ianeyk/magic-dds/report/images/dac_grid_schematic.png

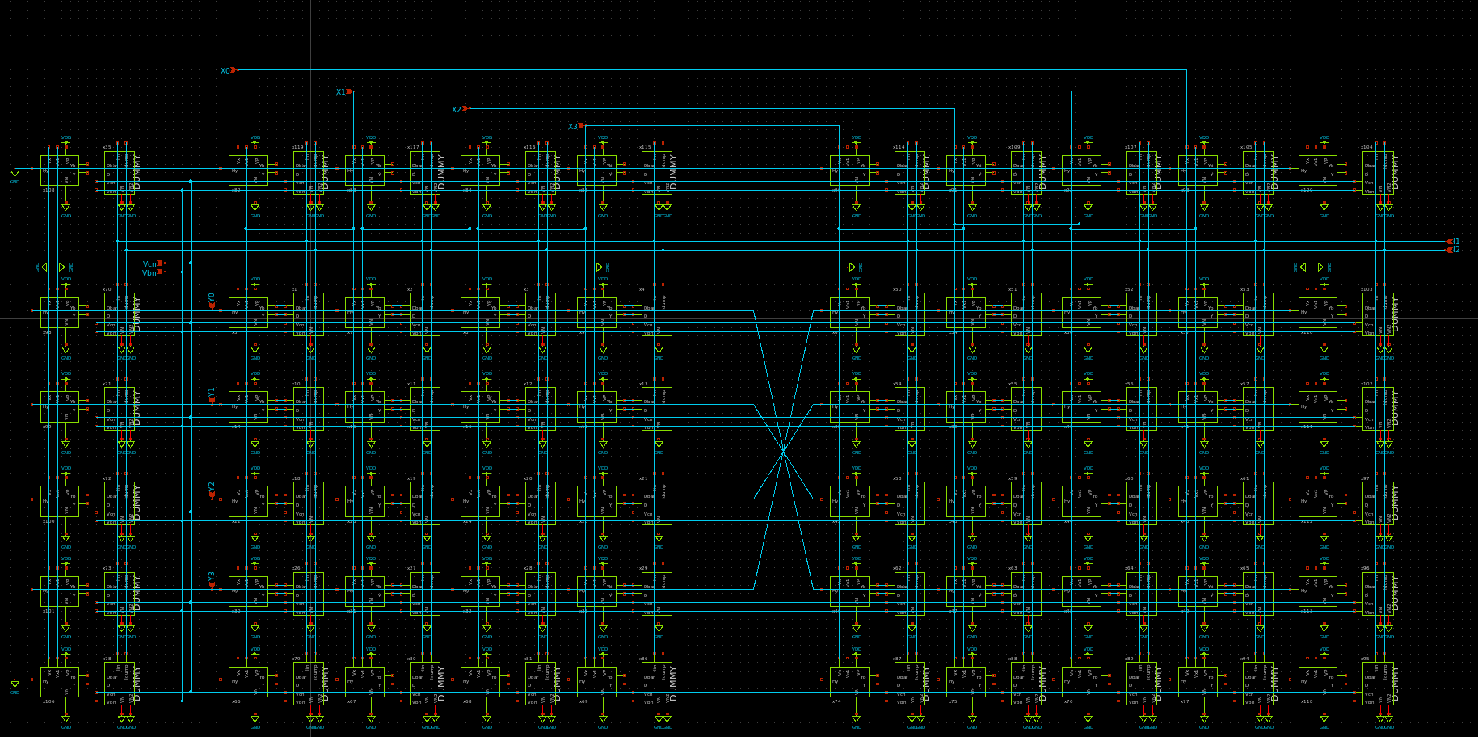
report/images/dac_grid_schematic.png
