ianeyk/magic-dds/report/images/not used yet/full_system_schematic_for_final_lvs.png

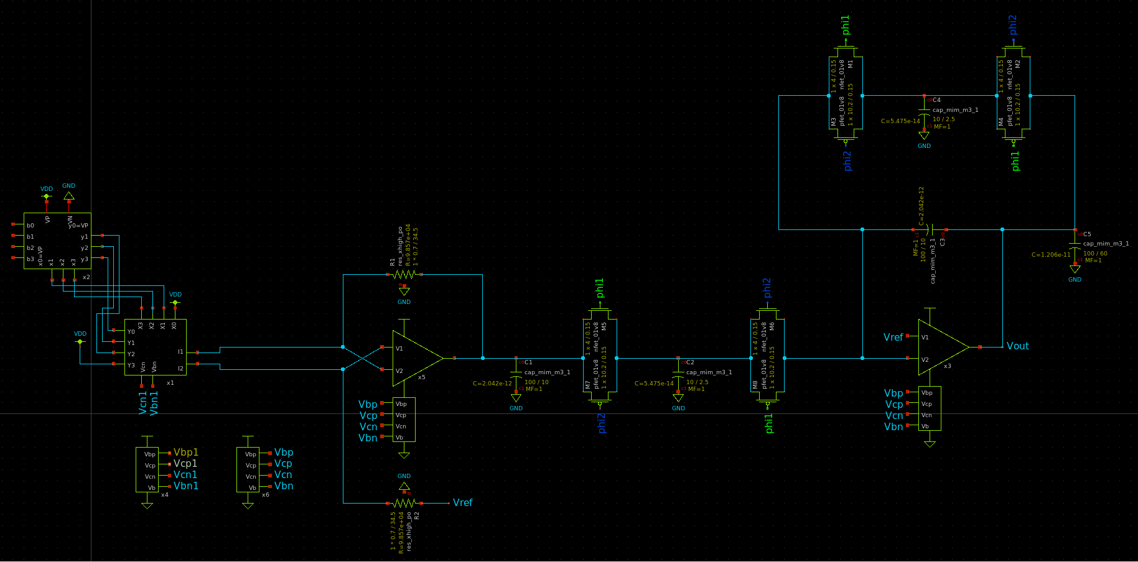
report/images/not used yet/full_system_schematic_for_final_lvs.png
