ianeyk/magic-dds/report/images/not used yet/output_sin_wave_from_switched_capacitor_16ns_clock_period.png

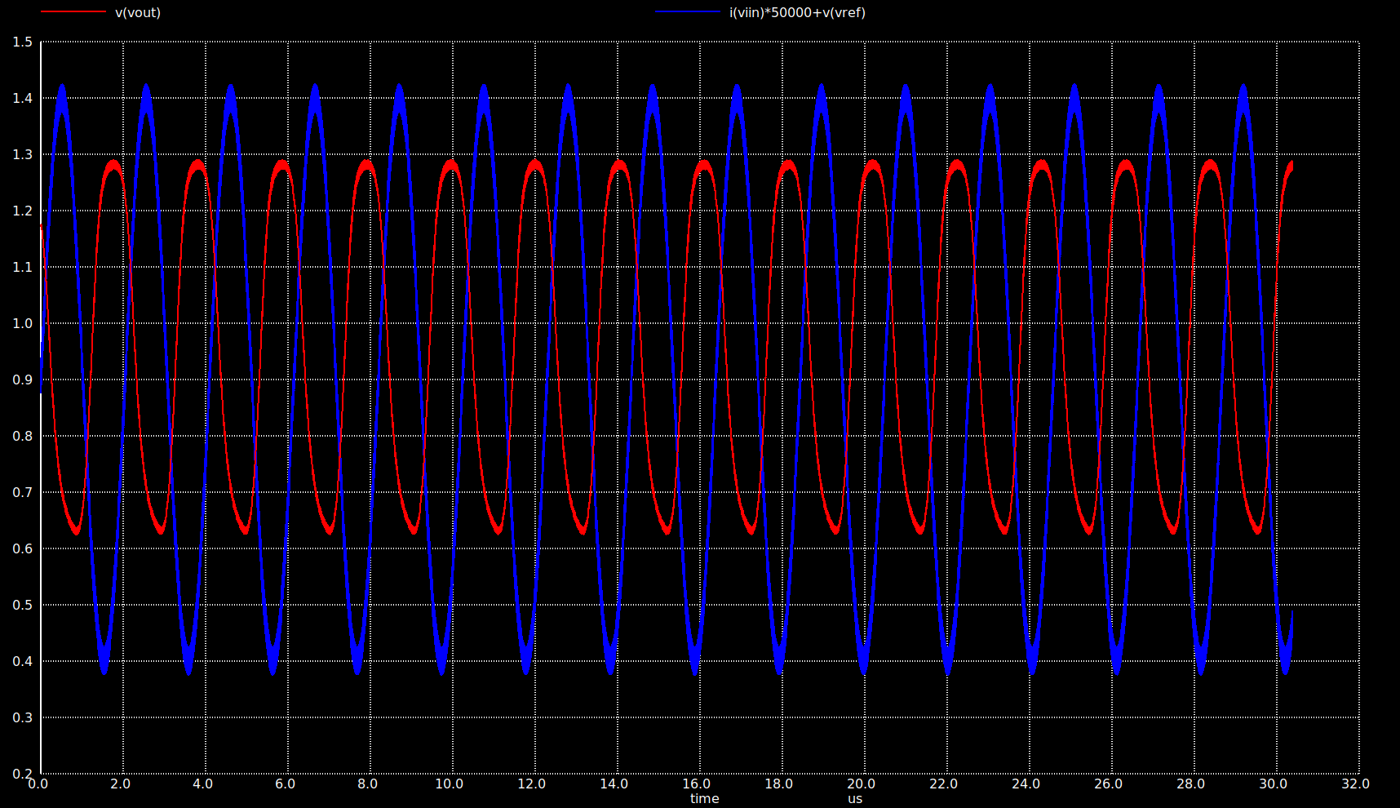
report/images/not used yet/output_sin_wave_from_switched_capacitor_16ns_clock_period.png
