ianeyk/magic-dds/report/images/not used yet/Screenshot from 2023-12-17 03-46-52.png

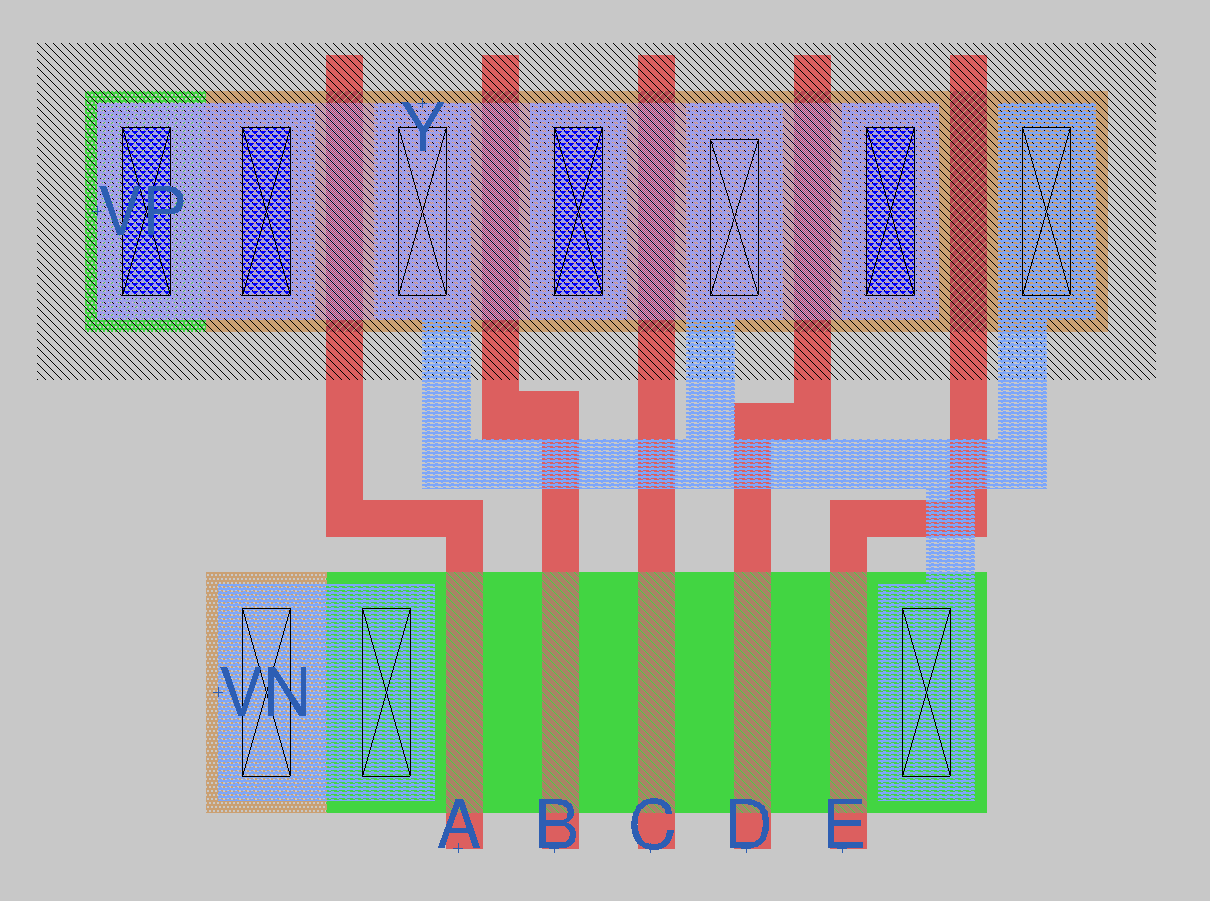
report/images/not used yet/Screenshot from 2023-12-17 03-46-52.png
