ianeyk/magic-dds/report/images/switched_capacitor_circuit_2.png

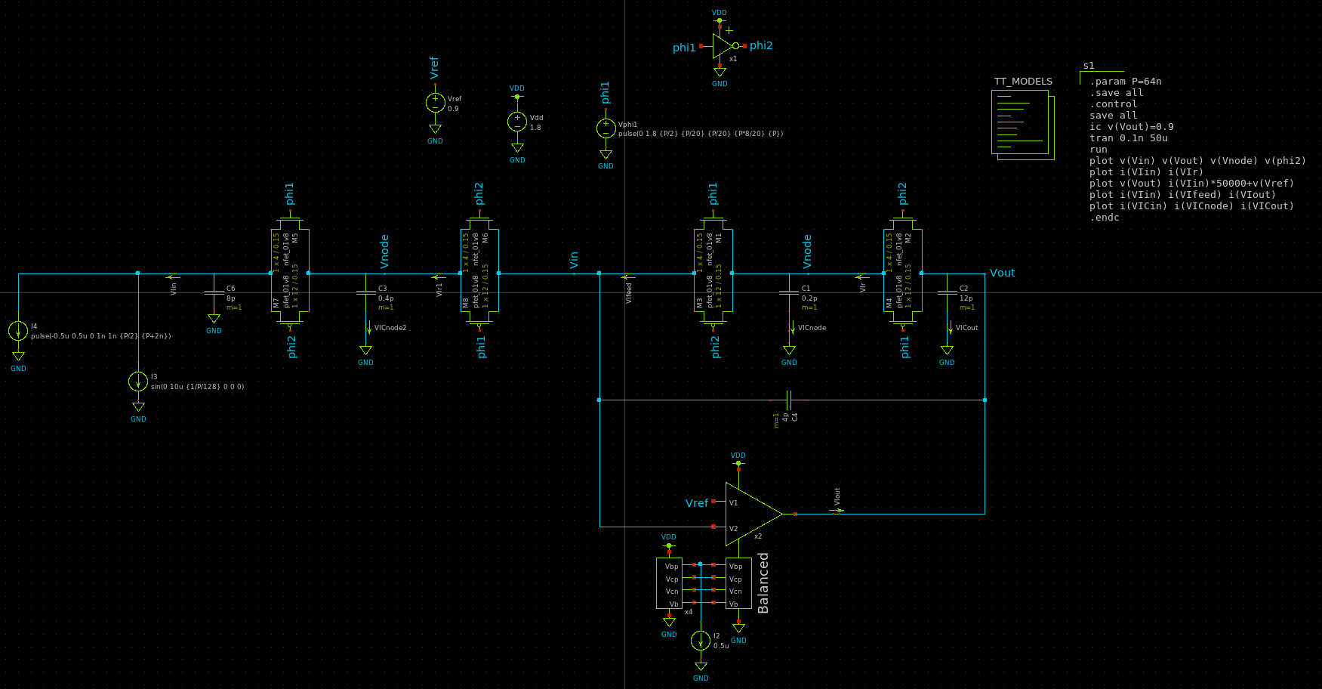
report/images/switched_capacitor_circuit_2.png
