ianeyk/magic-dds/report/images/unit_cell_current_steering_schematic.png

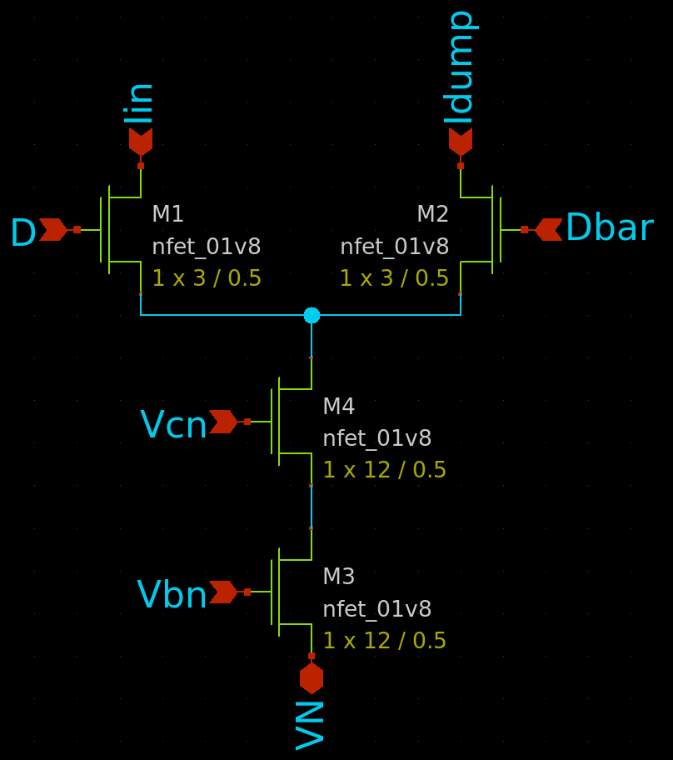
report/images/unit_cell_current_steering_schematic.png
