ianeyk/magic-dds/report/images/unit_cell_decoder_schematic.png

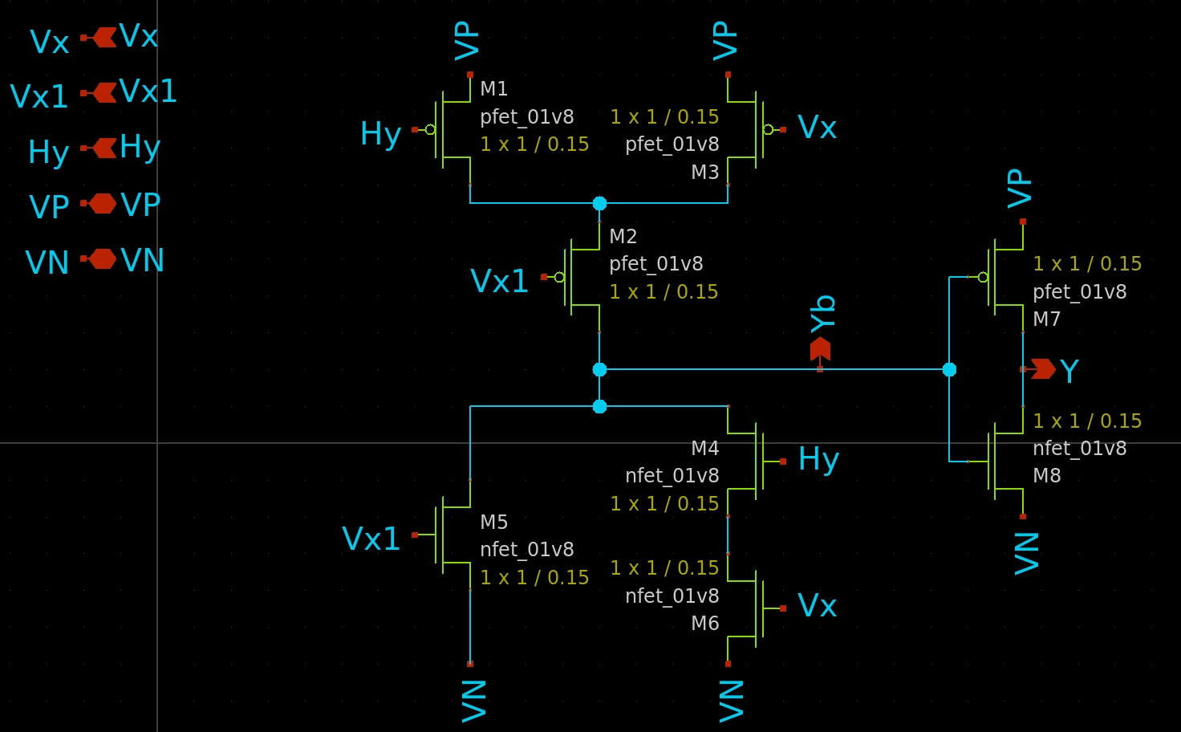
report/images/unit_cell_decoder_schematic.png
