ianeyk/magic-dds/magic/dac_with_output_stage_lvs.spice

** sch_path: /home/madvlsi/dev/git/magic-dds/lvs/dac_with_output_stage_lvs.sch
**.subckt dac_with_output_stage_lvs
x1 Vcn1 Vbn1 net4 net3 net1 net2 net6 net7 net8 VDD VDD net5 current_steering_dac
x2 net5 net8 VDD net13 net14 net4 net7 net15 net16 GND net6 net3 binary_decoder_4bit_lvs
x5 Vbp Vcp net9 net2 net1 Vcn Vbn opamp_balanced_lvs
x4 Vbp1 Vcn1 Vcp1 Vbn1 bias_schematic_lvs
x6 Vbp Vcn Vcp Vbn bias_schematic_lvs
x3 Vbp Vcp Vout Vref net11 Vcn Vbn opamp_balanced_lvs
XR1 net9 net1 GND sky130_fd_pr__res_xhigh_po W=0.7 L=34.5 mult=1 m=1
XR2 net2 Vref GND sky130_fd_pr__res_xhigh_po W=0.7 L=34.5 mult=1 m=1
XC1 net9 GND sky130_fd_pr__cap_mim_m3_1 W=100 L=10 MF=1 m=1
XM5 net10 phi1 net9 GND sky130_fd_pr__nfet_01v8 L=0.15 W=4 nf=1 ad='int((nf+1)/2) * W/nf * 0.29' as='int((nf+2)/2) * W/nf * 0.29'
+ pd='2*int((nf+1)/2) * (W/nf + 0.29)' ps='2*int((nf+2)/2) * (W/nf + 0.29)' nrd='0.29 / W' nrs='0.29 / W'
+ sa=0 sb=0 sd=0 mult=1 m=1
XM6 net11 phi2 net10 GND sky130_fd_pr__nfet_01v8 L=0.15 W=4 nf=1 ad='int((nf+1)/2) * W/nf * 0.29' as='int((nf+2)/2) * W/nf * 0.29'
+ pd='2*int((nf+1)/2) * (W/nf + 0.29)' ps='2*int((nf+2)/2) * (W/nf + 0.29)' nrd='0.29 / W' nrs='0.29 / W'
+ sa=0 sb=0 sd=0 mult=1 m=1
XM7 net10 phi2 net9 VDD sky130_fd_pr__pfet_01v8 L=0.15 W=10.2 nf=1 ad='int((nf+1)/2) * W/nf * 0.29' as='int((nf+2)/2) * W/nf * 0.29'
+ pd='2*int((nf+1)/2) * (W/nf + 0.29)' ps='2*int((nf+2)/2) * (W/nf + 0.29)' nrd='0.29 / W' nrs='0.29 / W'
+ sa=0 sb=0 sd=0 mult=1 m=1
XM8 net11 phi1 net10 VDD sky130_fd_pr__pfet_01v8 L=0.15 W=10.2 nf=1 ad='int((nf+1)/2) * W/nf * 0.29'
+ as='int((nf+2)/2) * W/nf * 0.29' pd='2*int((nf+1)/2) * (W/nf + 0.29)' ps='2*int((nf+2)/2) * (W/nf + 0.29)'
+ nrd='0.29 / W' nrs='0.29 / W' sa=0 sb=0 sd=0 mult=1 m=1
XC2 net10 GND sky130_fd_pr__cap_mim_m3_1 W=10 L=2.5 MF=1 m=1
XC3 Vout net11 sky130_fd_pr__cap_mim_m3_1 W=100 L=10 MF=1 m=1
XM1 net12 phi1 net11 GND sky130_fd_pr__nfet_01v8 L=0.15 W=4 nf=1 ad='int((nf+1)/2) * W/nf * 0.29' as='int((nf+2)/2) * W/nf * 0.29'
+ pd='2*int((nf+1)/2) * (W/nf + 0.29)' ps='2*int((nf+2)/2) * (W/nf + 0.29)' nrd='0.29 / W' nrs='0.29 / W'
+ sa=0 sb=0 sd=0 mult=1 m=1
XM2 Vout phi2 net12 GND sky130_fd_pr__nfet_01v8 L=0.15 W=4 nf=1 ad='int((nf+1)/2) * W/nf * 0.29' as='int((nf+2)/2) * W/nf * 0.29'
+ pd='2*int((nf+1)/2) * (W/nf + 0.29)' ps='2*int((nf+2)/2) * (W/nf + 0.29)' nrd='0.29 / W' nrs='0.29 / W'
+ sa=0 sb=0 sd=0 mult=1 m=1
XM3 net12 phi2 net11 VDD sky130_fd_pr__pfet_01v8 L=0.15 W=10.2 nf=1 ad='int((nf+1)/2) * W/nf * 0.29'
+ as='int((nf+2)/2) * W/nf * 0.29' pd='2*int((nf+1)/2) * (W/nf + 0.29)' ps='2*int((nf+2)/2) * (W/nf + 0.29)'
+ nrd='0.29 / W' nrs='0.29 / W' sa=0 sb=0 sd=0 mult=1 m=1
XM4 Vout phi1 net12 VDD sky130_fd_pr__pfet_01v8 L=0.15 W=10.2 nf=1 ad='int((nf+1)/2) * W/nf * 0.29' as='int((nf+2)/2) * W/nf * 0.29'
+ pd='2*int((nf+1)/2) * (W/nf + 0.29)' ps='2*int((nf+2)/2) * (W/nf + 0.29)' nrd='0.29 / W' nrs='0.29 / W'
+ sa=0 sb=0 sd=0 mult=1 m=1
XC4 net12 GND sky130_fd_pr__cap_mim_m3_1 W=10 L=2.5 MF=1 m=1
XC5 Vout GND sky130_fd_pr__cap_mim_m3_1 W=100 L=60 MF=1 m=1
**.ends

* expanding   symbol:  /home/madvlsi/dev/git/magic-dds/lvs/current_steering_dac.sym # of pins=12
** sym_path: /home/madvlsi/dev/git/magic-dds/lvs/current_steering_dac.sym
** sch_path: /home/madvlsi/dev/git/magic-dds/lvs/current_steering_dac.sch
.subckt current_steering_dac Vcn Vbn X2 X3 I1 I2 Y0 Y1 Y2 Y3 X0 X1
*.ipin I1
*.ipin I2
*.ipin X0
*.ipin X1
*.ipin X2
*.ipin X3
*.ipin Y0
*.ipin Y1
*.ipin Y2
*.ipin Y3
*.ipin Vcn
*.ipin Vbn
x5 X0 X1 Y0 VDD GND net1 net2 unit_cell_decoder
x7 X1 X2 Y0 VDD GND net3 net4 unit_cell_decoder
x8 X2 X3 Y0 VDD GND net5 net6 unit_cell_decoder
x9 X3 GND Y0 VDD GND net7 net8 unit_cell_decoder
x14 X0 X1 Y1 VDD GND net9 net10 unit_cell_decoder
x15 X1 X2 Y1 VDD GND net11 net12 unit_cell_decoder
x16 X2 X3 Y1 VDD GND net13 net14 unit_cell_decoder
x17 X3 GND Y1 VDD GND net15 net16 unit_cell_decoder
x22 X0 X1 Y2 VDD GND net17 net18 unit_cell_decoder
x23 X1 X2 Y2 VDD GND net19 net20 unit_cell_decoder
x24 X2 X3 Y2 VDD GND net21 net22 unit_cell_decoder
x25 X3 GND Y2 VDD GND net23 net24 unit_cell_decoder
x30 X0 X1 Y3 VDD GND net25 net26 unit_cell_decoder
x31 X1 X2 Y3 VDD GND net27 net28 unit_cell_decoder
x32 X2 X3 Y3 VDD GND net29 net30 unit_cell_decoder
x33 X3 GND Y3 VDD GND net31 net32 unit_cell_decoder
x1 I1 I2 net1 net2 Vcn Vbn GND current_steering_cell
x2 I1 I2 net3 net4 Vcn Vbn GND current_steering_cell
x3 I1 I2 net5 net6 Vcn Vbn GND current_steering_cell
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
x78 I1 I2 Vcn Vbn GND GND dummy_current_steering_cell
x79 I1 I2 Vcn Vbn GND GND dummy_current_steering_cell
x80 I1 I2 Vcn Vbn GND GND dummy_current_steering_cell
x81 I1 I2 Vcn Vbn GND GND dummy_current_steering_cell
x86 I1 I2 Vcn Vbn GND GND dummy_current_steering_cell
x87 I1 I2 Vcn Vbn GND GND dummy_current_steering_cell
x88 I1 I2 Vcn Vbn GND GND dummy_current_steering_cell
x89 I1 I2 Vcn Vbn GND GND dummy_current_steering_cell
x94 I1 I2 Vcn Vbn GND GND dummy_current_steering_cell
x95 I1 I2 Vcn Vbn GND GND dummy_current_steering_cell
x96 I1 I2 Vcn Vbn GND GND dummy_current_steering_cell
x97 I1 I2 Vcn Vbn GND GND dummy_current_steering_cell
x102 I1 I2 Vcn Vbn GND GND dummy_current_steering_cell
x103 I1 I2 Vcn Vbn GND GND dummy_current_steering_cell
x104 I1 I2 Vcn Vbn GND GND dummy_current_steering_cell
x105 I1 I2 Vcn Vbn GND GND dummy_current_steering_cell
x107 I1 I2 Vcn Vbn GND GND dummy_current_steering_cell
x109 I1 I2 Vcn Vbn GND GND dummy_current_steering_cell
x114 I1 I2 Vcn Vbn GND GND dummy_current_steering_cell
x115 I1 I2 Vcn Vbn GND GND dummy_current_steering_cell
x116 I1 I2 Vcn Vbn GND GND dummy_current_steering_cell
x117 I1 I2 Vcn Vbn GND GND dummy_current_steering_cell
x119 I1 I2 Vcn Vbn GND GND dummy_current_steering_cell
.ends


* expanding   symbol:  /home/madvlsi/dev/git/magic-dds/xschem/binary_decoder_4bit_lvs.sym # of
*+ pins=12
** sym_path: /home/madvlsi/dev/git/magic-dds/xschem/binary_decoder_4bit_lvs.sym
** sch_path: /home/madvlsi/dev/git/magic-dds/xschem/binary_decoder_4bit_lvs.sch
.subckt binary_decoder_4bit_lvs x1 y1 VP b0 b1 x2 y2 b2 b3 VN y3 x3
*.ipin b0
*.ipin b1
*.ipin b2
*.ipin b3
*.opin x3
*.iopin VP
*.iopin VN
*.opin y1
*.opin y2
*.opin y3
*.opin x1
*.opin x2
XM1 VN b0 net1 GND sky130_fd_pr__nfet_01v8 L=0.15 W=1 nf=1 ad='int((nf+1)/2) * W/nf * 0.29' as='int((nf+2)/2) * W/nf * 0.29'
+ pd='2*int((nf+1)/2) * (W/nf + 0.29)' ps='2*int((nf+2)/2) * (W/nf + 0.29)' nrd='0.29 / W' nrs='0.29 / W'
+ sa=0 sb=0 sd=0 mult=1 m=1
XM2 net1 b1 VN GND sky130_fd_pr__nfet_01v8 L=0.15 W=1 nf=1 ad='int((nf+1)/2) * W/nf * 0.29' as='int((nf+2)/2) * W/nf * 0.29'
+ pd='2*int((nf+1)/2) * (W/nf + 0.29)' ps='2*int((nf+2)/2) * (W/nf + 0.29)' nrd='0.29 / W' nrs='0.29 / W'
+ sa=0 sb=0 sd=0 mult=1 m=1
XM3 VN net1 y1 GND sky130_fd_pr__nfet_01v8 L=0.15 W=1 nf=1 ad='int((nf+1)/2) * W/nf * 0.29' as='int((nf+2)/2) * W/nf * 0.29'
+ pd='2*int((nf+1)/2) * (W/nf + 0.29)' ps='2*int((nf+2)/2) * (W/nf + 0.29)' nrd='0.29 / W' nrs='0.29 / W'
+ sa=0 sb=0 sd=0 mult=1 m=1
XM4 net2 b1 VN GND sky130_fd_pr__nfet_01v8 L=0.15 W=1 nf=1 ad='int((nf+1)/2) * W/nf * 0.29' as='int((nf+2)/2) * W/nf * 0.29'
+ pd='2*int((nf+1)/2) * (W/nf + 0.29)' ps='2*int((nf+2)/2) * (W/nf + 0.29)' nrd='0.29 / W' nrs='0.29 / W'
+ sa=0 sb=0 sd=0 mult=1 m=1
XM5 VN net2 y2 GND sky130_fd_pr__nfet_01v8 L=0.15 W=1 nf=1 ad='int((nf+1)/2) * W/nf * 0.29' as='int((nf+2)/2) * W/nf * 0.29'
+ pd='2*int((nf+1)/2) * (W/nf + 0.29)' ps='2*int((nf+2)/2) * (W/nf + 0.29)' nrd='0.29 / W' nrs='0.29 / W'
+ sa=0 sb=0 sd=0 mult=1 m=1
XM6 y3 net3 VN GND sky130_fd_pr__nfet_01v8 L=0.15 W=1 nf=1 ad='int((nf+1)/2) * W/nf * 0.29' as='int((nf+2)/2) * W/nf * 0.29'
+ pd='2*int((nf+1)/2) * (W/nf + 0.29)' ps='2*int((nf+2)/2) * (W/nf + 0.29)' nrd='0.29 / W' nrs='0.29 / W'
+ sa=0 sb=0 sd=0 mult=1 m=1
XM7 net5 b1 VN GND sky130_fd_pr__nfet_01v8 L=0.15 W=1 nf=1 ad='int((nf+1)/2) * W/nf * 0.29' as='int((nf+2)/2) * W/nf * 0.29'
+ pd='2*int((nf+1)/2) * (W/nf + 0.29)' ps='2*int((nf+2)/2) * (W/nf + 0.29)' nrd='0.29 / W' nrs='0.29 / W'
+ sa=0 sb=0 sd=0 mult=1 m=1
XM8 net3 b0 net5 GND sky130_fd_pr__nfet_01v8 L=0.15 W=1 nf=1 ad='int((nf+1)/2) * W/nf * 0.29' as='int((nf+2)/2) * W/nf * 0.29'
+ pd='2*int((nf+1)/2) * (W/nf + 0.29)' ps='2*int((nf+2)/2) * (W/nf + 0.29)' nrd='0.29 / W' nrs='0.29 / W'
+ sa=0 sb=0 sd=0 mult=1 m=1
XM9 net4 b0 net1 VDD sky130_fd_pr__pfet_01v8 L=0.15 W=1 nf=1 ad='int((nf+1)/2) * W/nf * 0.29' as='int((nf+2)/2) * W/nf * 0.29'
+ pd='2*int((nf+1)/2) * (W/nf + 0.29)' ps='2*int((nf+2)/2) * (W/nf + 0.29)' nrd='0.29 / W' nrs='0.29 / W'
+ sa=0 sb=0 sd=0 mult=1 m=1
XM10 VP b1 net4 VDD sky130_fd_pr__pfet_01v8 L=0.15 W=1 nf=1 ad='int((nf+1)/2) * W/nf * 0.29' as='int((nf+2)/2) * W/nf * 0.29'
+ pd='2*int((nf+1)/2) * (W/nf + 0.29)' ps='2*int((nf+2)/2) * (W/nf + 0.29)' nrd='0.29 / W' nrs='0.29 / W'
+ sa=0 sb=0 sd=0 mult=1 m=1
XM11 VP net1 y1 VDD sky130_fd_pr__pfet_01v8 L=0.15 W=1 nf=1 ad='int((nf+1)/2) * W/nf * 0.29' as='int((nf+2)/2) * W/nf * 0.29'
+ pd='2*int((nf+1)/2) * (W/nf + 0.29)' ps='2*int((nf+2)/2) * (W/nf + 0.29)' nrd='0.29 / W' nrs='0.29 / W'
+ sa=0 sb=0 sd=0 mult=1 m=1
XM12 net2 b1 VP VDD sky130_fd_pr__pfet_01v8 L=0.15 W=1 nf=1 ad='int((nf+1)/2) * W/nf * 0.29' as='int((nf+2)/2) * W/nf * 0.29'
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
+ pd='2*int((nf+1)/2) * (W/nf + 0.29)' ps='2*int((nf+2)/2) * (W/nf + 0.29)' nrd='0.29 / W' nrs='0.29 / W'
+ sa=0 sb=0 sd=0 mult=1 m=1
XM29 VP net7 x2 VDD sky130_fd_pr__pfet_01v8 L=0.15 W=1 nf=1 ad='int((nf+1)/2) * W/nf * 0.29' as='int((nf+2)/2) * W/nf * 0.29'
+ pd='2*int((nf+1)/2) * (W/nf + 0.29)' ps='2*int((nf+2)/2) * (W/nf + 0.29)' nrd='0.29 / W' nrs='0.29 / W'
+ sa=0 sb=0 sd=0 mult=1 m=1
XM30 x3 net8 VP VDD sky130_fd_pr__pfet_01v8 L=0.15 W=1 nf=1 ad='int((nf+1)/2) * W/nf * 0.29' as='int((nf+2)/2) * W/nf * 0.29'
+ pd='2*int((nf+1)/2) * (W/nf + 0.29)' ps='2*int((nf+2)/2) * (W/nf + 0.29)' nrd='0.29 / W' nrs='0.29 / W'
+ sa=0 sb=0 sd=0 mult=1 m=1
XM31 VP b3 net8 VDD sky130_fd_pr__pfet_01v8 L=0.15 W=1 nf=1 ad='int((nf+1)/2) * W/nf * 0.29' as='int((nf+2)/2) * W/nf * 0.29'
+ pd='2*int((nf+1)/2) * (W/nf + 0.29)' ps='2*int((nf+2)/2) * (W/nf + 0.29)' nrd='0.29 / W' nrs='0.29 / W'
+ sa=0 sb=0 sd=0 mult=1 m=1
XM32 net8 b2 VP VDD sky130_fd_pr__pfet_01v8 L=0.15 W=1 nf=1 ad='int((nf+1)/2) * W/nf * 0.29' as='int((nf+2)/2) * W/nf * 0.29'
+ pd='2*int((nf+1)/2) * (W/nf + 0.29)' ps='2*int((nf+2)/2) * (W/nf + 0.29)' nrd='0.29 / W' nrs='0.29 / W'
+ sa=0 sb=0 sd=0 mult=1 m=1
.ends
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
