ianeyk/magic-dds/(commit log)

2023-11-29 port over files from old repo
    [bias_schematic.sch, current_steering_cell.sch, current_steering_testbench.sch, current_steering_testbench_pmos_cascode_mirror.sch, current_steering_testbench_pmos_mirror.sch, current_steering_testbench_with_decoder.sch, ieee_DAC_mc_simulation_69.sch, inverter.sch]
2023-12-01 add IV converter stage
    [current_steering_testbench_current_difference.sch, current_steering_testbench_opamp_iv_2stage_R.sch, current_steering_testbench_opamp_iv_R.sch, opamp_schematic.sch]
2023-12-06 start switched capacitor analysis
    [switched_capacitor_iv_converter.sch, switched_capacitor_lpf.sch, switched_capacitor_ohms_law.sch]
2023-12-06 sort of working switched capacitor IV converter
    [switched_capacitor_iv_converter.sch]
2023-12-06 tweak capacitor values and switching frequency
    [switched_capacitor_iv_converter.sch]
2023-12-07 IV converter works great if you increase the resolution of the simulation
    [switched_capacitor_iv_converter.sch]
2023-12-07 create 4-bit decoder and run transient simulation on 16-cell current steering dac
    [binary_decoder_4bit.sch, current_steering_testbench_transient_code_sweep.sch, nand.sch, nor.sch]
2023-12-07 add switched capacitor iv converter to current steering dac output
    [current_steering_testbench_transient_sciv.sch]
2023-12-09 best results with phi1 and phi1
    [current_steering_testbench_transient_sciv.sch, switched_capacitor_dual_iv_converter.sch]
2023-12-11 begin current dac cell layout
2023-12-11 play around with simulations
    [current_steering_cell.sch, switched_capacitor_dual_iv_converter.sch, switched_capacitor_iv_converter.sch]
2023-12-11 run lvs; netlists do not match
    [current_steering_unit_cell_with_decoder_for_lvs.sch]
2023-12-12 circuits match uniquely for current steering dac cell
    [current_steering_unit_cell_with_decoder_for_lvs.sch]
2023-12-12 start 16-cell common centroided dac layout driven schematic
    [current_steering_dac_with_4_bit_decoder.sch]
2023-12-12 recreate xschem unit cell model for lvs
    [current_steering_cell.sch, unit_cell_decoder.sch, unit_cell_for_lvs.sch]
2023-12-12 create dummy unit cell layout
    [current_steering_dac_with_4_bit_decoder.sch, dummy_current_steering_cell.sch, dummy_unit_cell_for_lvs.sch]
2023-12-12 start layout of 16-cell dac
    [current_steering_dac_with_4_bit_decoder.sch, dummy_current_steering_cell.sch]
2023-12-12 incorrect wiring save point
2023-12-12 separate dac symbol and decoder symbol
    [current_steering_dac.sch, dac_with_decoder.sch]
2023-12-12 init on sin cl
    [counter.sch, counter_testbench.sch, dflipflop.sch, sin_cl.sch, untitled.sch, xnor.sch]
2023-12-13 finish first pass of current steering dac including port labels
2023-12-13 add Vbn and Vcn ports in schematic
    [current_steering_dac.sch, dac_with_decoder.sch]
2023-12-13 add more logic stuff
    [counter.sch, counter_testbench.sch, inverter.sch]
2023-12-13 adjust lpf capacitor values
    [switched_capacitor_lpf.sch, switched_capacitor_second_stage_lpf.sch, test_values_switched_capacitor_iv_converter.sch]
2023-12-14 test total harmonic distortion (thd) of low pass iv converter
    [opamp_schematic.sch, opamp_schematic_balanced.sch, switched_capacitor_iv_lpf.sch, test_values_switched_capacitor_iv_converter.sch]
2023-12-14 create more switched capacitor lpf iv converter simulations
    [poor_mans_bode_plot_iv_converter.sch, resistor_iv_converter_bode.sch, switched_capacitor_iv_bode_2_part.sch, switched_capacitor_iv_converter_bode.sch, switched_capacitor_iv_lpf.sch, test_values_switched_capacitor_iv_converter.sch]
2023-12-14 fix some lvs differences; add psd regions to cells
    [poor_mans_bode_plot_iv_converter.sch]
2023-12-14 current steering dac circuits match uniquely
2023-12-15 make balanced layouts and schematics of current difference and op amp
    [current_difference_balanced.sch, current_steering_testbench_current_difference_symbol.sch, opamp_balanced_lvs.sch]
2023-12-15 undo balancing of current difference circuit
2023-12-15 undo balancing of current difference circuit (2)
    [current_difference_balanced.sch]
2023-12-15 first pass at layout for 2-bit binary decoder
    [binary_decoder_4bit_lvs.sch, poor_mans_bode_plot_iv_converter.sch]
2023-12-15 check layout-driven schematic for 4-bit binary decoder
2023-12-15 lvs on layout-driven schematic for 4-bit binary decoder
    [binary_decoder_4bit_fancy_lvs.sch, fancy_decoder_with_ground.sch, inverter.sch, lvs_decoder_with_ground.sch]
2023-12-15 run lvs on 4 bit binary decoder layout. Circuits match uniquely.
2023-12-15 combine decoder and dac
    [poor_mans_bode_plot_iv_converter.sch]
2023-12-15 wip setting up lvs
    [bias_schematic_lvs.sch, dac_decoder_current_diff_bias_lvs.sch, untitled.sch]
2023-12-16 dac, decoder, current difference, op amp, and bias all integrated together; circuits match uniquely
    [dac_decoder_current_diff_bias_lvs.sch]
2023-12-16 beautiful sine wave output in switched_capacitor_iv_lpf.sch
    [switched_capacitor_iv_lpf.sch]
2023-12-16 updated logic gates ad sin cl to more closly resemble what they should be
    [nand3.sch, nand4.sch, nand5.sch, sin_cl.sch]
2023-12-16 init verson of sin cl
    [sin_cl.sch]
2023-12-16 play around and make lots of fixes
    [counter.sch, counter_testbench.sch, dflipflop.sch, sin_cl.sch]
2023-12-16 choose final capacitor values
    [switched_capacitor_iv_lpf.sch]
2023-12-16 nice second order low pass filter simulations
    [switched_capacitor_iv_lpf_second_order.sch, switched_capacitor_iv_lpf_third_order.sch]
2023-12-16 add transmission gate and milestone working third order output stage
    [switched_capacitor_iv_lpf_third_order.sch]
2023-12-16 add screenshots for report
    [switched_capacitor_iv_lpf_third_order_small_capacitors.sch]
2023-12-16 init woring sin gen
    [counter.sch, counter_testbench.sch, current_steering_testbench_transient_full1.sch, sr-flipflop.sch, sr-latch.sch, untitled-1.sch]
2023-12-16 start combinational logic layout
    [current_steering_testbench_transient_full1.sch, switched_capacitor_iv_lpf_third_order_diff_input.sch]
2023-12-16 various updates
    [switched_capacitor_iv_lpf_third_order_diff_input.sch]
2023-12-16 wip adding resistors
    [switched_capacitor_iv_lpf_third_order.sch, switched_capacitor_iv_lpf_third_order_test.sch]
2023-12-16 wip (2)
    [switched_capacitor_iv_lpf_third_order_test2.sch]
2023-12-16 add m2 ground plane
    [switched_capacitor_iv_lpf_third_order_diff_input.sch, switched_capacitor_iv_lpf_third_order_test2.sch]
2023-12-16 finish painting m2
    [switched_capacitor_iv_lpf_third_order_diff_input.sch]
2023-12-17 finish placing capacitors
2023-12-17 finish first pass of capacitor layout, including ground connections
2023-12-17 create xschem schematic for lvs
    [dac_with_output_stage_lvs.sch, switched_capacitor_iv_lpf_third_order_diff_input.sch]
2023-12-17 fix shorted capacitor in layout
    [dac_with_output_stage_lvs.sch]
2023-12-17 switch gates of trasmission gate clock signals
2023-12-17 circuits match uniquely
    [dac_with_output_stage_lvs.sch]
2023-12-17 fix property values in xschem; circuits match uniquely
    [dac_with_output_stage_lvs.sch]
